Robotinho/Robotinho/Cahier des charges.docx

Robotinho

Description du projet :

Robot footballeur + but :

-dont les déplacements sont contrôlés par l’utilisateur

-capable de propulser la balle dans la direction voulue

-but équipé d’un système de récupération de balle et de comptage automatique du score
