Robotinho/Robotinho/Soutenance/Robotinho.pptx

## Robotinho

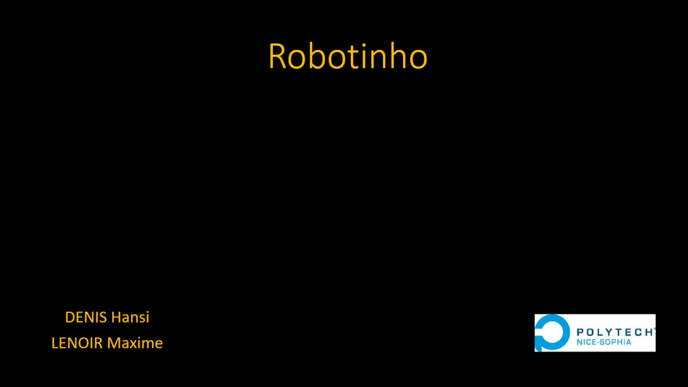
[picture p30: figure]
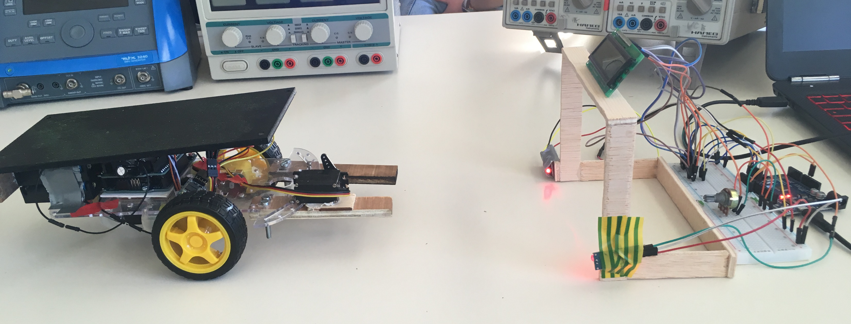
[picture p31: figure]

## Sommaire → Motivations et problématique → Objectifs → Fonctions et schémas → Matériel → Problèmes rencontrés → Planning → Conclusion – Perspectives → Démonstration

## Motivations et problématique

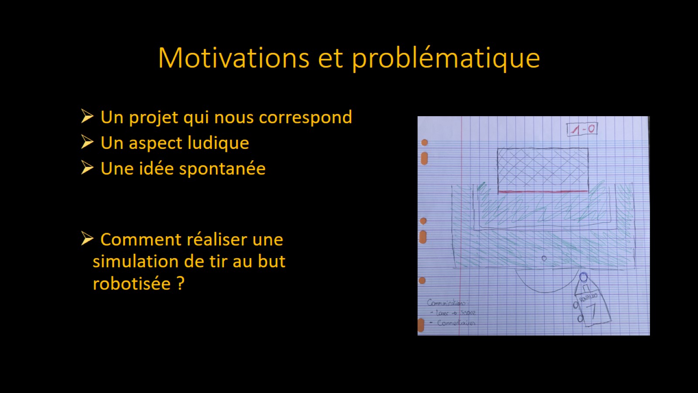
[picture p32: figure]

## Objectifs

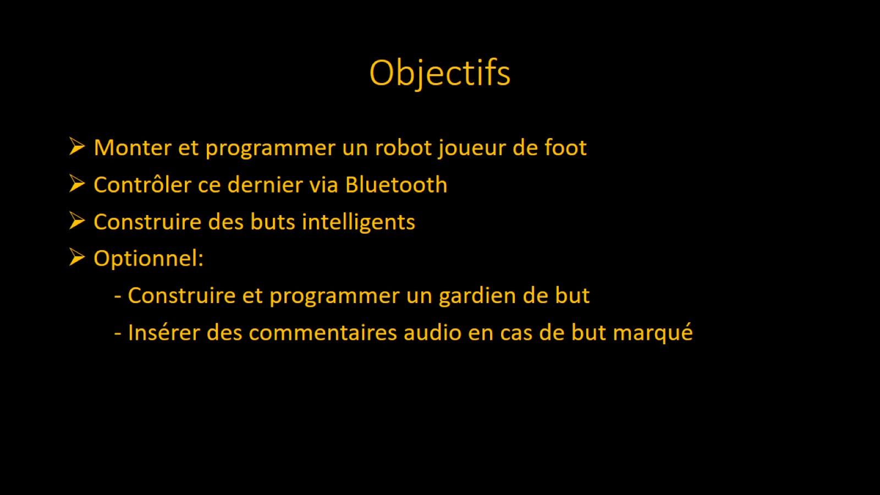
[picture p33: figure]

## Fonctions et Schémas: Robot

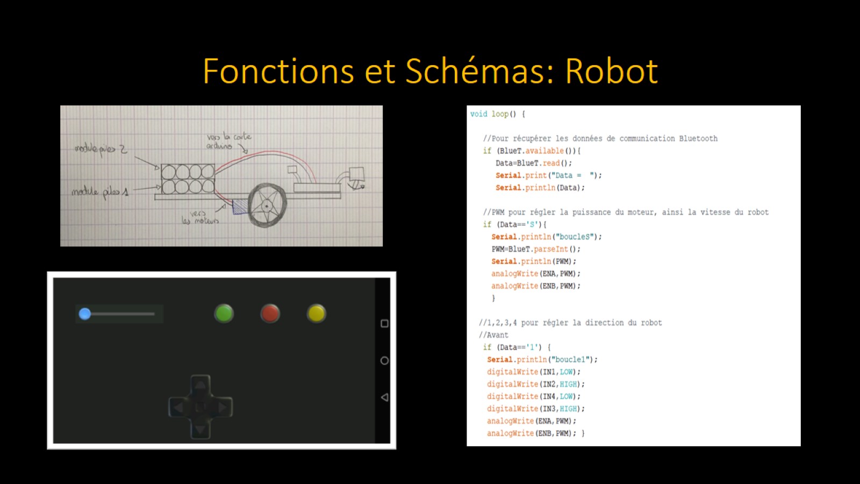
[picture p34: figure]

## Fonctions et Schémas: Cages

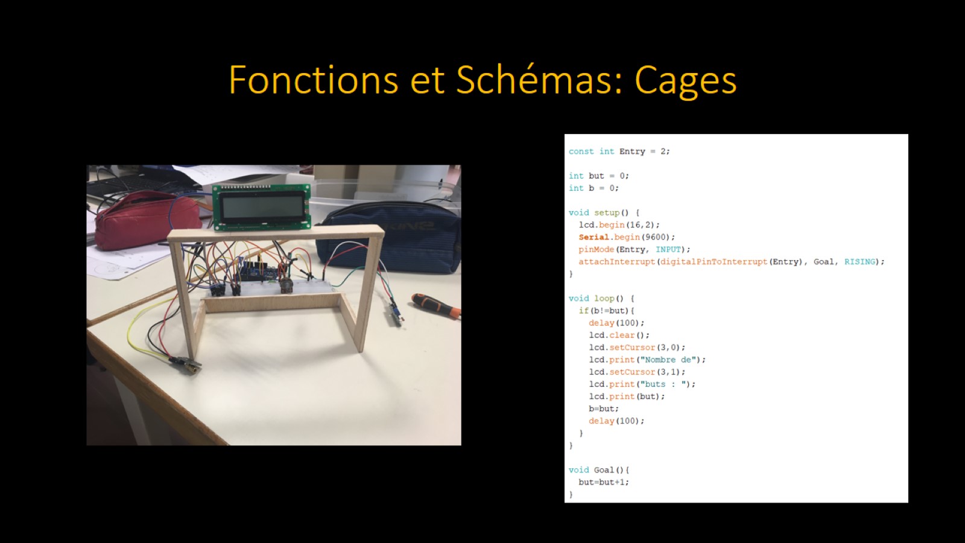
[picture p35: figure]

## Matériel

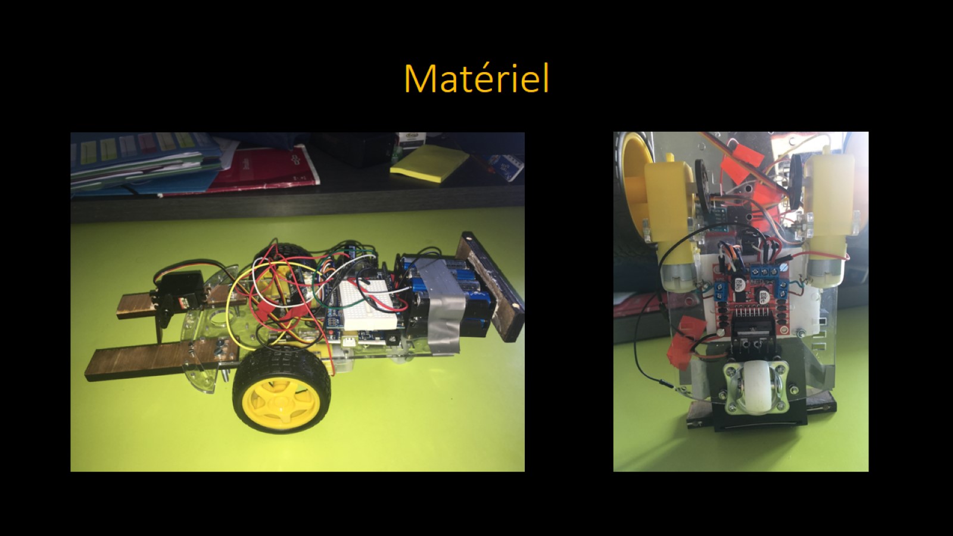
[picture p36: figure]

## Problèmes rencontrés

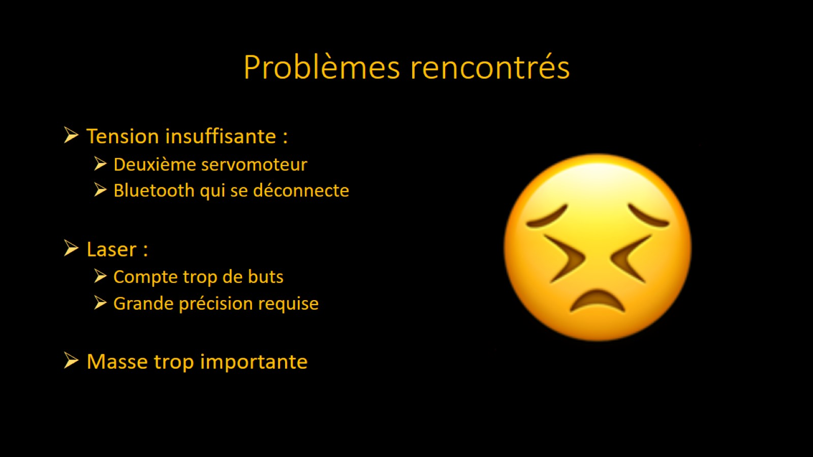
[picture p37: figure]

## Planning

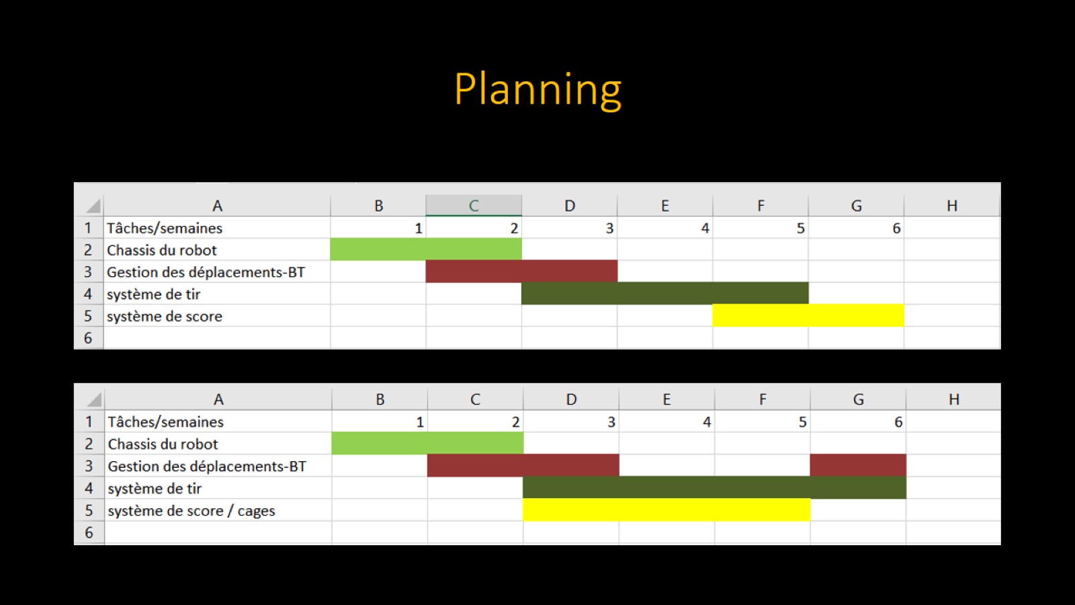
[picture p38: figure]

## Conclusion - Perspectives

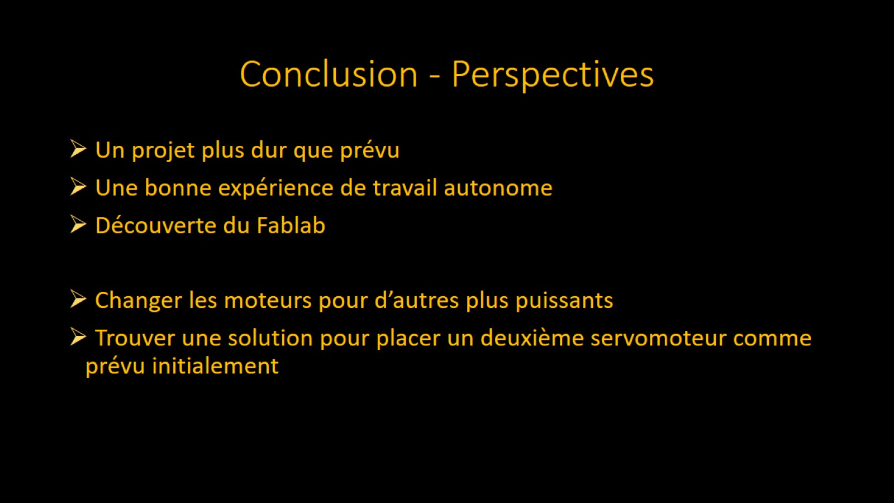
[picture p39: figure]
