Robotinho/Robotinho/Programmes finaux/Robotinho/BlueT_base/BlueT_base.ino

#include<SoftwareSerial.h>
#define RX 3
#define TX 11
SoftwareSerial BlueT(RX,TX);

void setup() {
  Serial.begin(9600);
  delay(500);
  Serial.println("Bonjour - Prêt pour les commandes AT");
  BlueT.begin(9600);
  delay(500);
}

void loop() {
  while(BlueT.available()){
    Serial.print(char(BlueT.read()));}
   while(Serial.available()){
    BlueT.write(char(Serial.read()));}
}
